desiFish/ESP32-GPS-CLOCK-V2/README.md

<div align="center">
  <h1>🌟 GPS-Clock-V2 ⏰</h1>
  <p><i>A smart GPS Clock with temperature, humidity, and light sensing capabilities</i></p>
  
  
  
  
  
  
  
  
</div>

## 📌 Introduction

This project is an enhanced version of [GPS-CLOCK-V1](https://github.com/desiFish/GPS-CLOCK-V1) with significant improvements:

- **Added Buttons**: Physical buttons for easy interaction with the device.
- **Menu System**: A comprehensive menu system for configuration and control.
- **Enhanced User Interface**: Improved display layouts and information presentation.
- **Additional Features**: New functionalities building upon the original project.

> Read ⚠️ Important Notice below gallery section for critical information about components and modifications.

## 🛠️ Hardware Components

### 📡 Core Components
1. **ESP32 Development Board** 
   - Dual-core processor up to 240MHz
   - Integrated Wi-Fi and Bluetooth
   - Operating voltage: 3.3V
   - Tested on: ESP32-Devkit-V1

2. **BH1750 Light Sensor** 🌞
   - 16-bit digital output
   - Range: 1-65535 lux
   - Power: 2.4-3.6V
   - I²C interface

3. **GPS Module (NEO-6M)** 🛰️
   - Update rate: 1-5 Hz
   - Position accuracy: 2.5m
   - Cold start: 27s typical
   - Hot start: 1s typical
   - Operating voltage: 3.0-3.6V

4. **ST7920 LCD Display** 📺
   - Resolution: 128x64 pixels
   - 5V logic level
   - Parallel/Serial interface

5. **Buzzer Module** 🔊
   - Active buzzer
   - Operating voltage: 3.3-5V
   - Frequency: ~2300Hz
   - Sound output: >85dB

6. **Push Buttons** x3 ⚡
   - Tactile momentary switches
   - Life cycle: 100,000 clicks
   - With caps for better feel
   - Two for Menu navigation, one for reset

7. **10K Potentiometer**
   - For contrast adjustment

### 🔋 Optional Components (Battery Backup)

#### Power Management
1. **LiFePO4 Battery** 
   - Capacity: 80mAh (AAA size)
   - Nominal voltage: 3.2V
   - Cycle life: >1500 cycles
   - Temperature range: -20°C to 60°C
   - Perfect for GPS backup

2. **TP5000 Charging Circuit** ⚡
   - Input voltage: 4.5-28V
   - Charging current: 0.5-2A
   - Efficiency: >90%
   - Built-in protection features
   - For GPS Battery

3. **Battery Protection** 🛡️
   - BMS for single cell
   - Using for Over-discharge protection

4. **Additional Components** 🔧
   - IN4007 diode (1A, 1000V)
   - JST connectors
   - Prototyping board
   - Silicone wires (better) or PVC Wires
   - Heat shrink tubing

### 💡 Compatibility Notes
- All I²C devices operate at 3.3V logic
- Power supply should provide at least 500mA @5V
- External antenna optional for GPS (Not Implemented)

### 🏗️ Construction Guide

#### 📦 Enclosure Preparation
* Used a standard PVC electrical junction box (IP55 rated for weather resistance)
  - Size: Approximately 150mm x 100mm x 70mm
  - Cost-effective alternative to 3D printing
  - Naturally resistant to moisture and dust
  - Available at most hardware stores

#### 🛠️ Tools Required
* Drill machine with metal cutting bits (for holes)
* Drill machine with metal cutting attachment that looks like CD (for rectangular cuts)
* Hot glue gun
* Wire strippers
* Soldering iron
* Basic hand tools (screwdrivers, pliers)
* Safety equipment (goggles, gloves)

#### 🔨 Assembly Steps
1. **Display Window Creation** 🪟
   * Mark display dimensions on box
   * Drill corner pilot holes
   * Use metal cutting bits for rough cut
   * File edges smooth for perfect fit
   * Pro tip: Use masking tape to prevent scratches

2. **Light Sensor Window** 💡
   * Create small 10mm opening for BH1750
   * Use clear epoxy or hot glue to seal
   * Ensure sensor faces directly outward
   * Keep sealed but transparent for accuracy

3. **Component Mounting** 🔌
   * Mount display using hot glue at corners
   * Create standoffs for ESP32 board
   * Position GPS antenna near top for best reception

#### 💡 Pro Tips
* Ensure proper ventilation while cutting/drilling PVC
* Double-check measurements before cutting
* Test all components before final assembly
* Label all wires for future maintenance
* Add small ventilation holes for the sensor
* Consider magnetic mount options
* Keep spare wire lengths for modifications
* Document your build with photos

## 🚀 Upcoming Features
Check [Issues](https://github.com/desiFish/ESP32-GPS-Clock-V2/issues)

## 📷 Pictures, Schematics and other stuff 
<table>
  <tr>
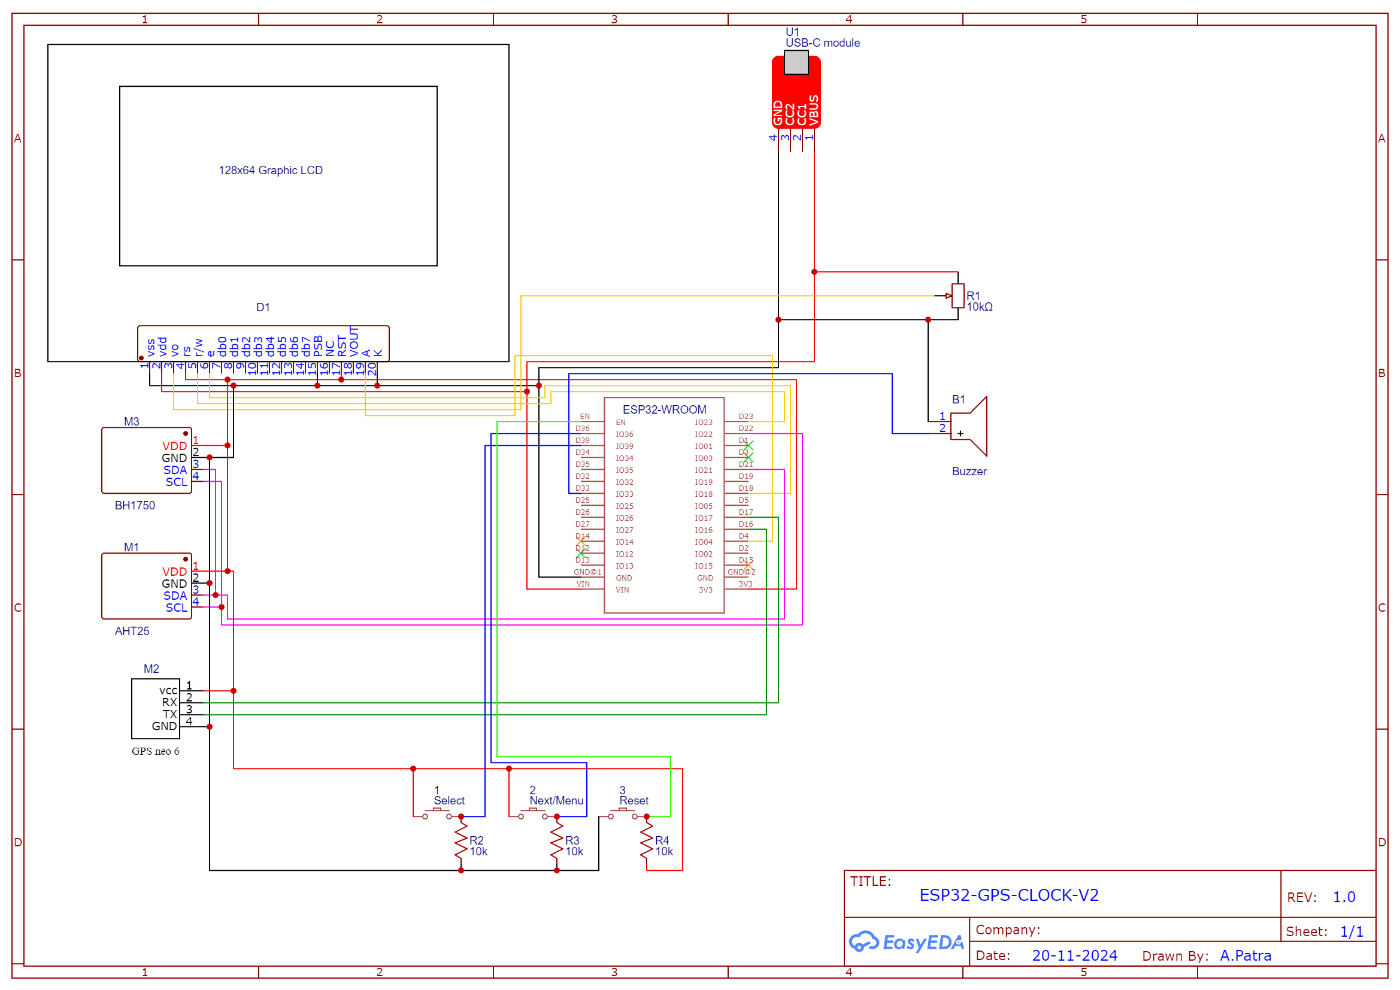
[picture p1: schematics/Schematic_ESP32-GPS-CLOCK-V2_2024-11-20.png]
Schematics
    <td><br><p align="center">Schematics</p></td>
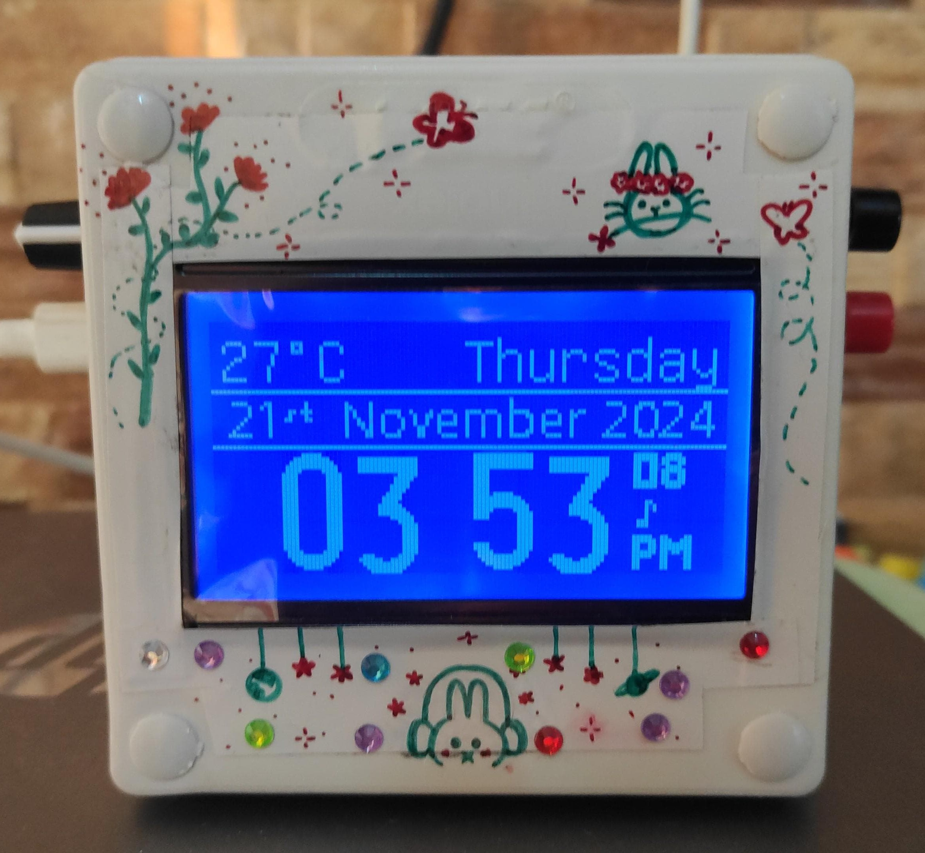
[picture p2: resources/x10.jpg]
    <td><br><p align="center">Front View</p></td>
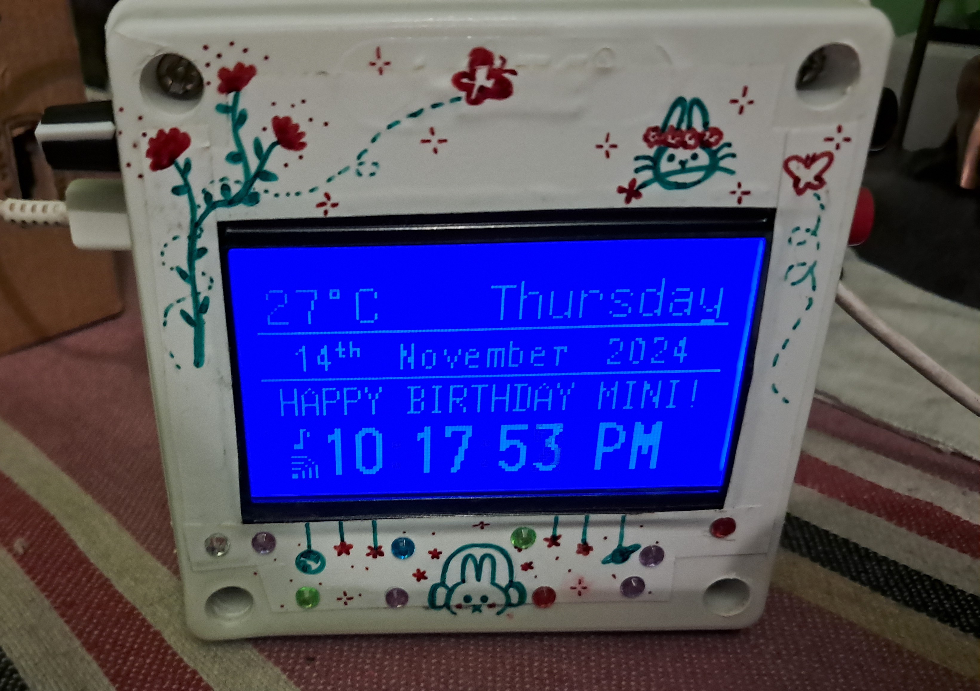
[picture p3: resources/x1.jpg]
    <td><br><p align="center">Front View</p></td>
  </tr>
  <tr>
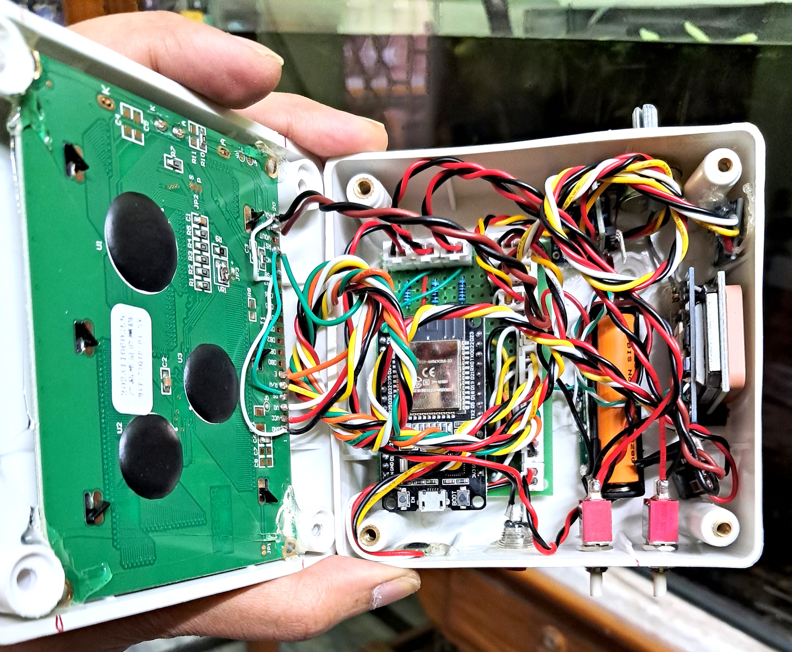
[picture p4: resources/x11.jpg]
inside
    <td><br><p align="center">Inside View</p></td>
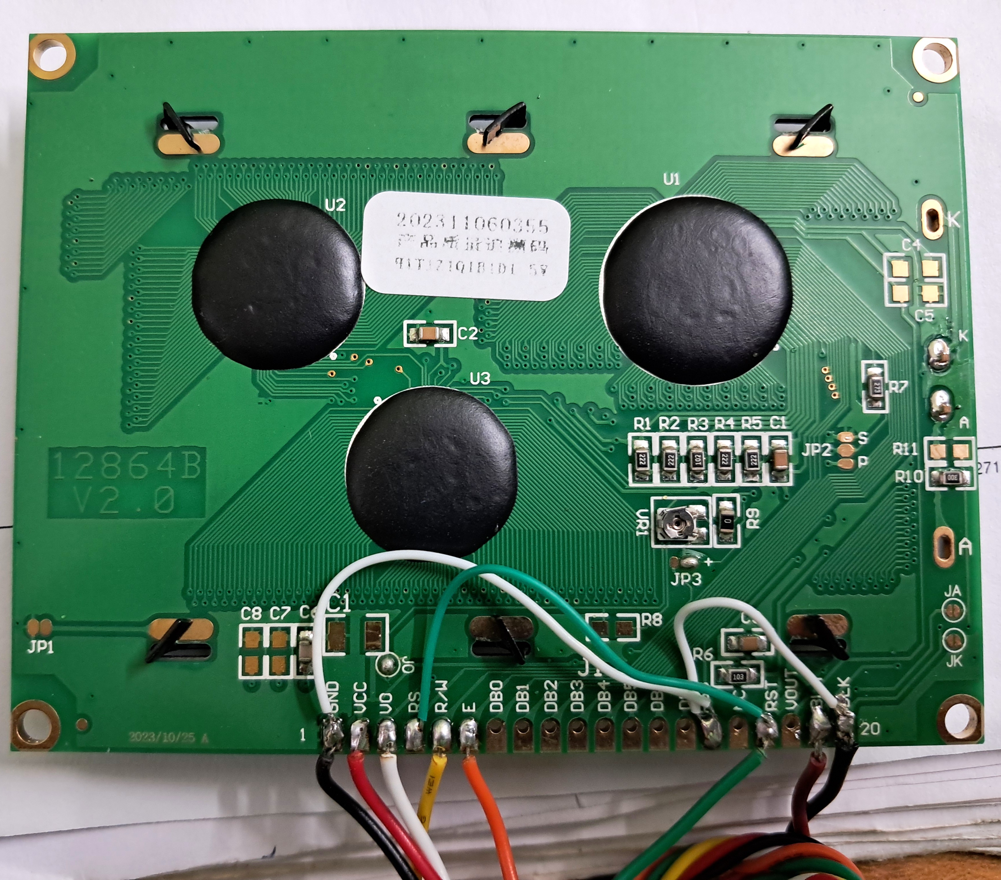
[picture p5: resources/x2.jpg]
display-connections
    <td><br><p align="center">Display Connections</p></td>
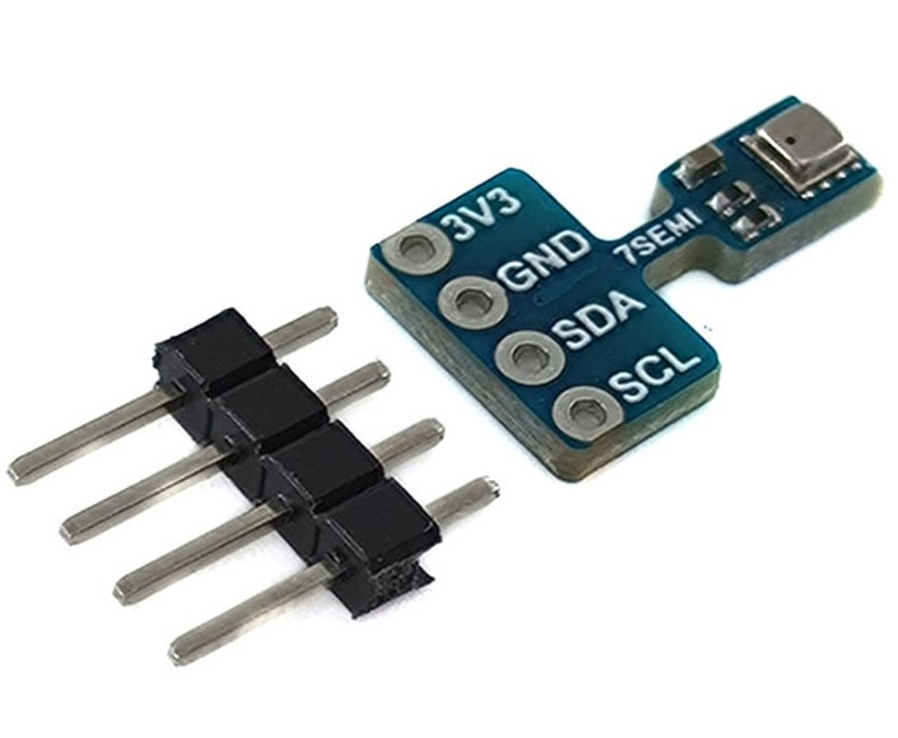
[picture p6: resources/x3.jpg]
bme280
    <td><br><p align="center">BME280 Sensor</p></td>
  </tr>
  <tr>
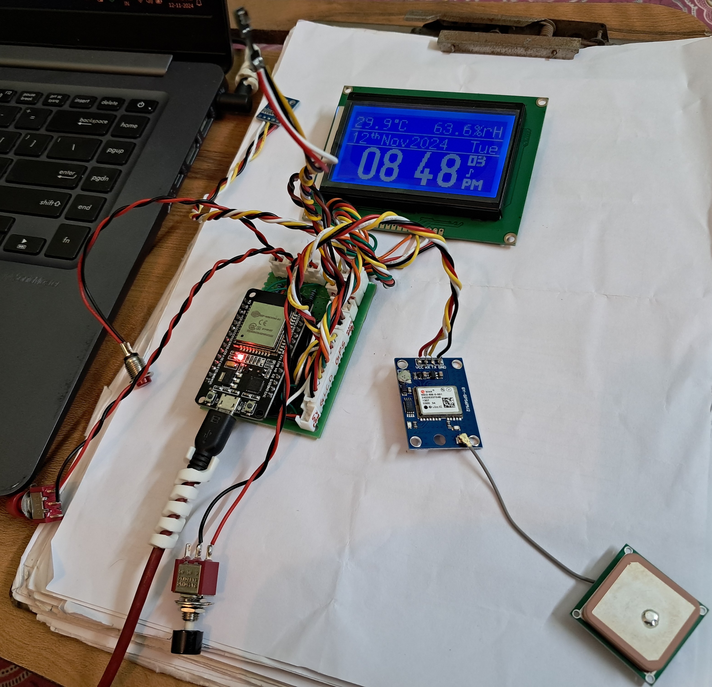
[picture p7: resources/x4.jpg]
testing-phase
    <td><br><p align="center">Testing Phase</p></td>
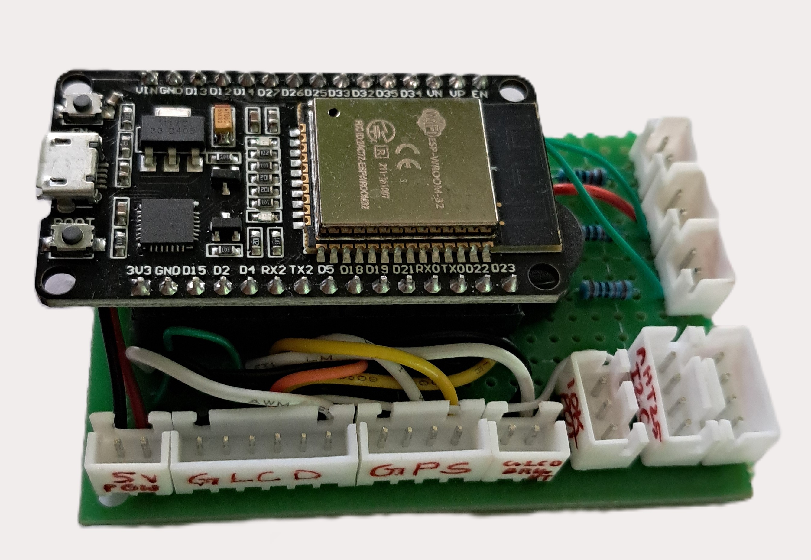
[picture p8: resources/x5.jpg]
esp32_with_connections
    <td><br><p align="center">ESP32 with Connections</p></td>
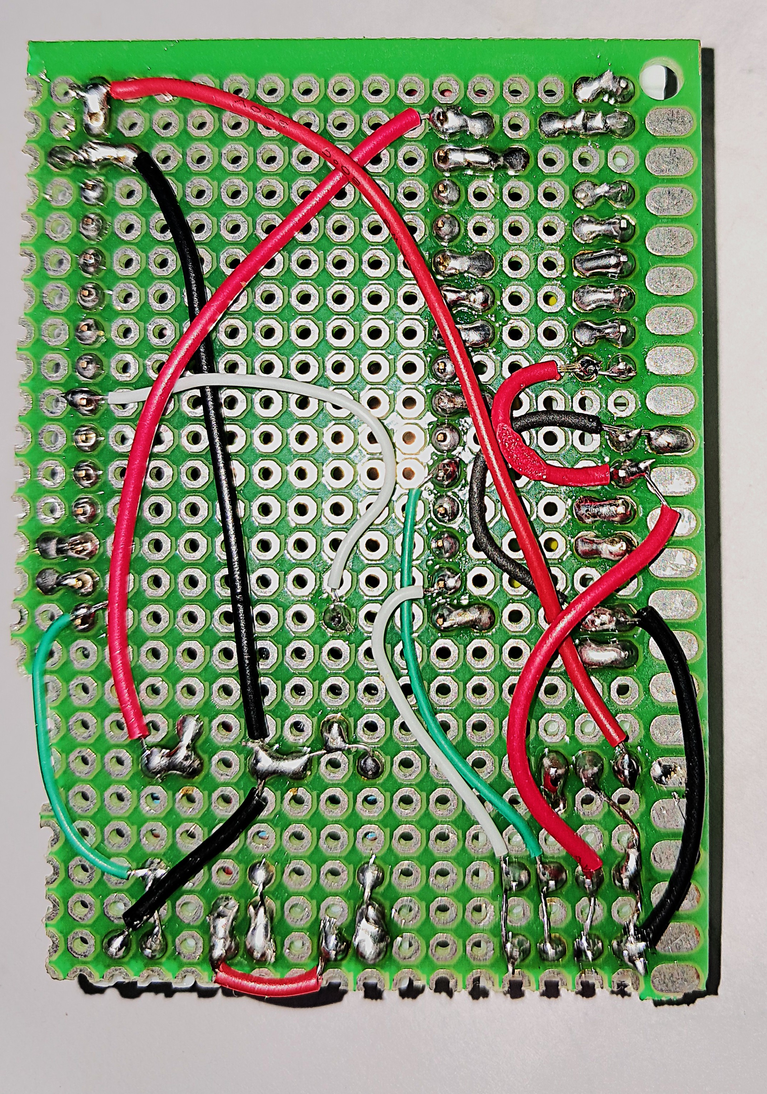
[picture p9: resources/x6.jpg]
circuit-connections
    <td><br><p align="center">Circuit Connections</p></td>
  </tr>
  <tr>
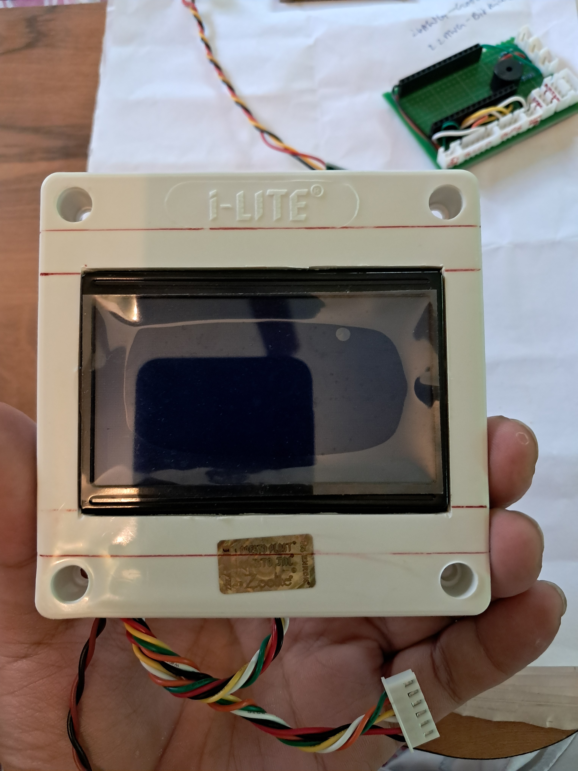
[picture p10: resources/x7.jpg]
cutting-display-window
    <td><br><p align="center">Cutting Display Window</p></td>
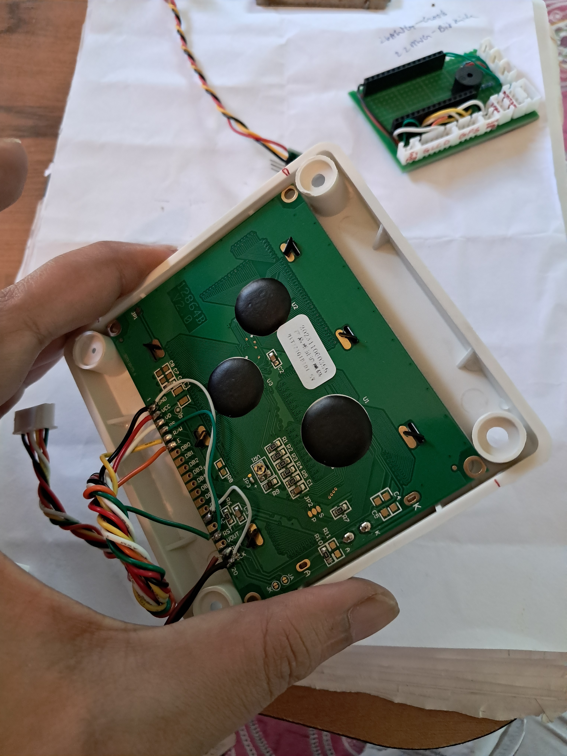
[picture p11: resources/x8.jpg]
display-in-plastic-frame
    <td><br><p align="center">Display in Plastic Frame</p></td>
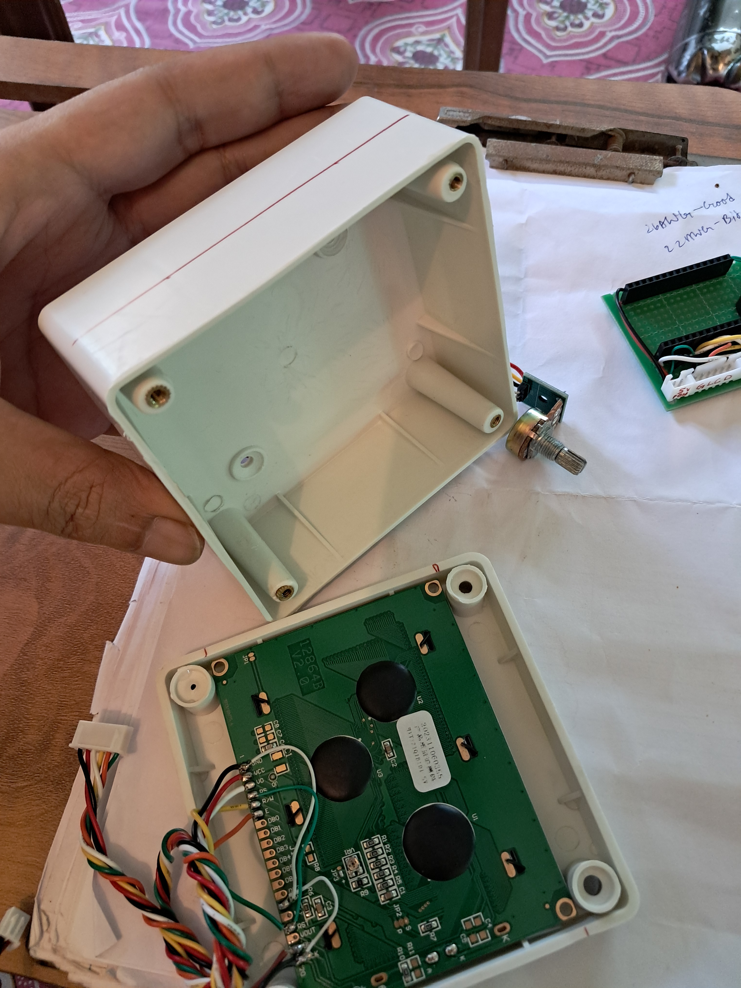
[picture p12: resources/x9.jpg]
fullview
    <td><br><p align="center">Full View</p></td>
  </tr>
</table>

<h2>⚠️ Important Notice</h2>
<div style="background-color: #fff3cd; padding: 10px; border-radius: 5px; border-left: 5px solid #ffeeba;">
  <strong>❌ DO NOT USE AHT25 SENSOR!</strong><br>
  Due to significant accuracy issues, we recommend using BME280/BMP280/TMP117 instead.
</div> <br>
<strong>🔋 GPS Battery Modification</strong>
<div style="background-color: #f8f9fa; padding: 15px; border-radius: 5px; margin-top: 10px;">
  <h4>⚠️ Known Issue with GPS Module's Internal Battery</h4>
  <p>
    The NEO-6M GPS modules often come with problematic internal rechargeable batteries that:
    <ul>
      <li>Are frequently dead on arrival</li>
      <li>Fail to hold charge properly</li>
      <li>Only last 15-20 minutes when disconnected</li>
      <li>Cannot be reliably recharged</li>
    </ul>
  </p>

  <h4>🛠️ Solution Implemented</h4>
  <p>
    To resolve this, I've made the following modifications:
    <ul>
      <li>Removed the internal battery and charging diode</li>
      <li>Installed a LiFePO4 battery (AAA size)</li>
      <li>Added TP5000 charging circuit for reliable charging</li>
      <li>Implemented BMS for deep discharge protection (Cut Off @2.5V, 2.9V Ideal)</li>
      <li>Added diode to drop voltage to 3V for GPS backup pin</li>
    </ul>
  </p>

  <h4>💡 User Options</h4>
  <div style="background-color: #e2e3e5; padding: 10px; border-radius: 5px;">
    <strong>You have two choices:</strong>
    <ol>
      <li><strong>Keep Original Battery:</strong> 
        <ul>
          <li>Suitable if clock remains powered most of the time</li>
          <li>No modifications needed</li>
        </ul>
      </li>
      <li><strong>Modify Battery (Recommended):</strong>
        <ul>
          <li>Better for frequent power cycles</li>
          <li>Eliminates 5-10 minute GPS lock delay on cold starts</li>
          <li>More reliable long-term solution</li>
        </ul>
      </li>
    </ol>
  </div>
</div>

## 📜 License

<details>
<summary>GNU General Public License v3.0</summary>

This project is protected under the GNU General Public License v3.0. This means:

- ✅ Commercial use is permitted
- ✅ Modification is permitted
- ✅ Distribution is permitted
- ✅ Private use is permitted
- ❗ License and copyright notice must be included
- ❗ Source code must be made available when distributing
- ❗ Changes must be documented
- ❗ Same license must be used

[View full license](https://www.gnu.org/licenses/gpl-3.0.en.html)
</details>

---
<div align="center">
  <p>Made with ❤️ for the IoT Community</p>
  
  
  
  <br>
  
  
  
</div>
