desiFish/ESP32-GPS-CLOCK-V2/schematics/Schematic_ESP32-GPS-CLOCK-V2_2024-11-20.pdf

A | A

1

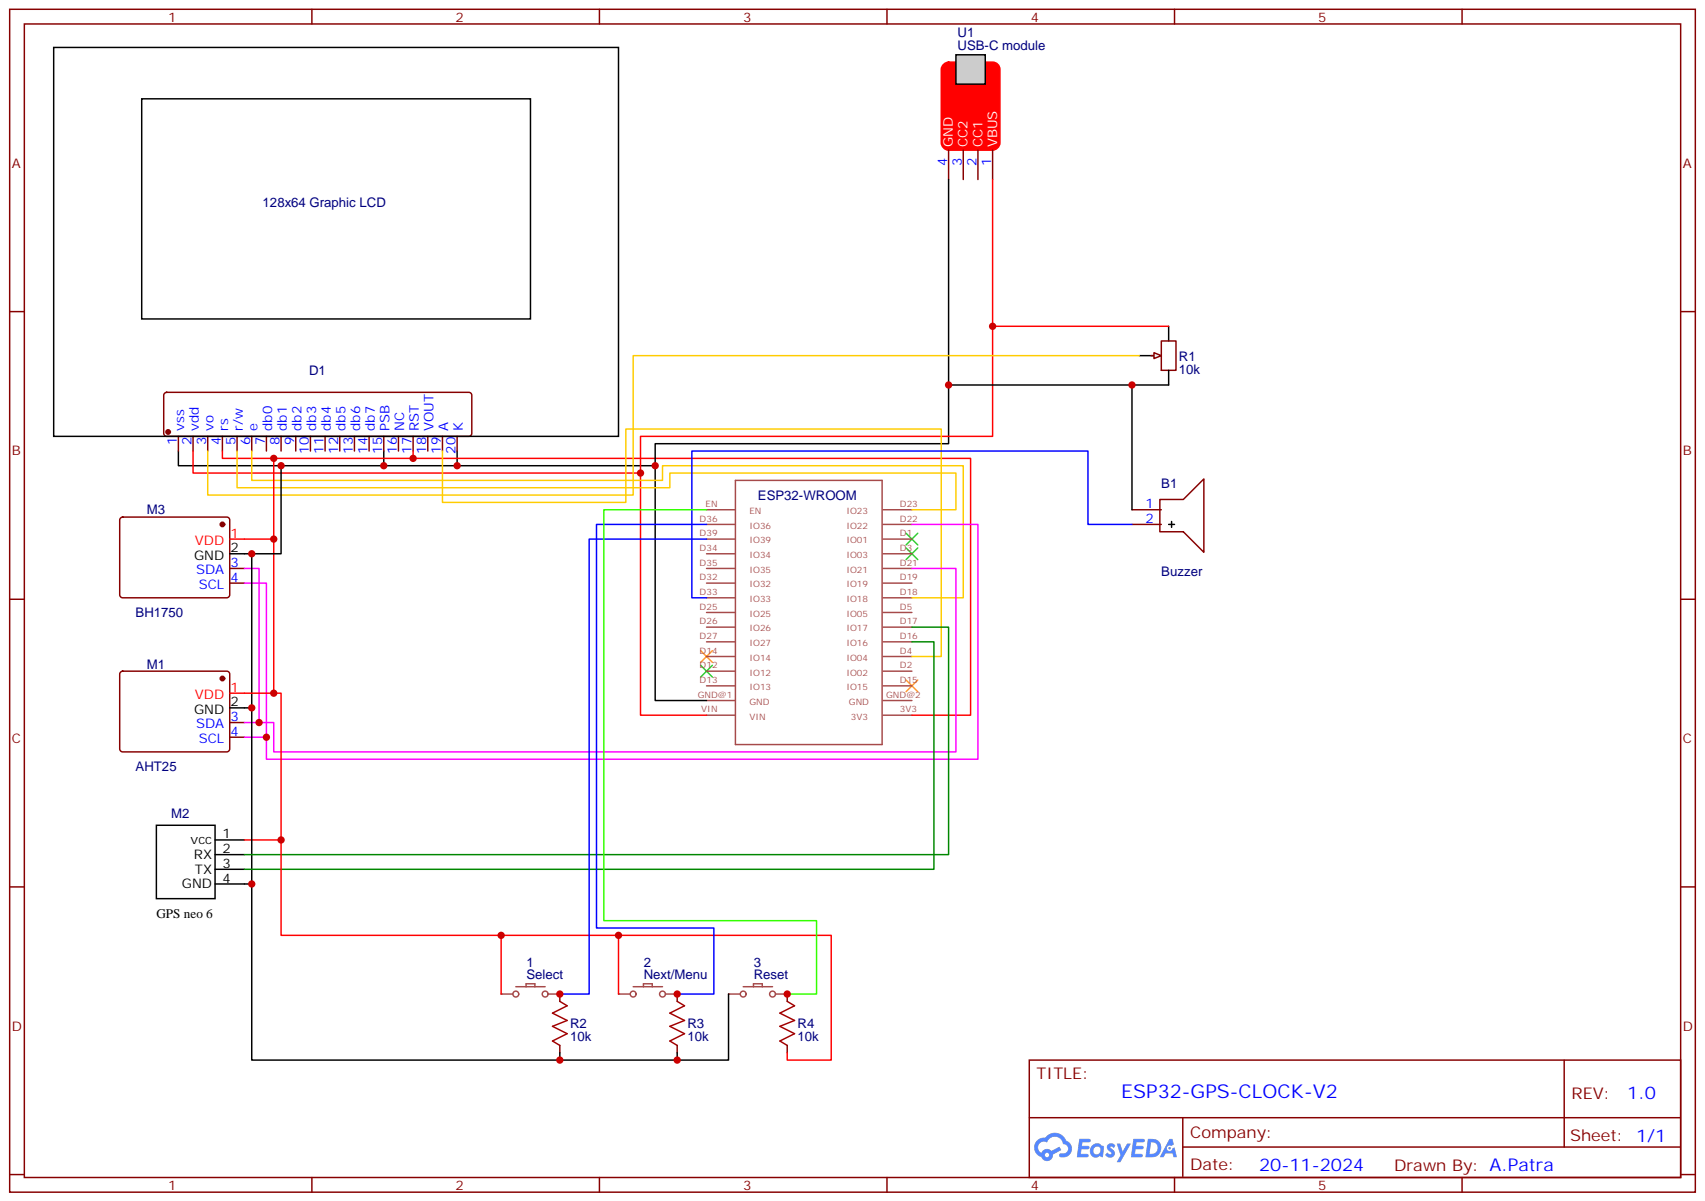
[picture p13: page 1]

D36 | | D22 D1 D3 D21
D39 D34 D35 D32 D33
