desiFish/ESP32-GPS-CLOCK-V2/(commit log)

2024-11-20 Updates to schematics
2024-12-06 V1.0.1
    * Minor bug fix
    * Performance Enhancement
    [ESP32-GPS-Clock-V2.ino]
2025-01-12 Update README.md to clarify important notice location and add details for menu navigation switches
2025-01-12 Add logo to ESP32 Development Board section in README.md
2025-01-12 Add detailed function documentation for OTA and configuration functions in ESP32-GPS-Clock-V2.ino
2025-01-12 Enhance documentation in ESP32-GPS-Clock-V2.ino with detailed comments for software version, library includes, hardware configuration, pin definitions, control pins, global variables, and function de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
2025-01-12 Bump software version to 1.0.2 in ESP32-GPS-Clock-V2.ino
2025-01-12 Update copyright notice and license in ESP32-GPS-Clock-V2.ino
2025-01-12 Rename file to match project naming convention in ESP32-GPS-Clock-V2.ino
2025-01-12 Update copyright notice in ESP32-GPS-Clock-V2.ino
2025-02-26 Update ESP32-GPS-Clock-V2.ino with version bump to 1.1.1, improved light state tracking, and refined alarm logic
2025-02-26 Update README.md with battery cycle life adjustment, compatibility notes, and construction guide details
2025-03-03 Refactor setup function to enhance initialization sequence; adjust LCD brightness, buzzer delay, and add display messages for improved user experience
    [ESP32-GPS-Clock-V2.ino]
2025-03-04 Fix typo in WiFi prompt message for clarity
    [GPS-CLOCK-V2.ino]
2025-09-20 v1.1.3 - fixed when buzzer keeps buzzing when GPS time is not available
    [GPS-CLOCK-V2.ino]
2025-09-23 for v2.0.0 - enhanced time management using time.h over timelib.h - fixed half-hourly or hourly buzzers buzzing on UTC time rather than local time - enhanced "pulse" working - better debug options - 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
    [GPS-CLOCK-V2.ino]
